ZhuohengLee/Squid-Robot/ESP32/KalmanFilter.h

/**********************************************************************
 * KalmanFilter.h
 *
 * Three-state depth filter tracking position, velocity, and acceleration.
 *********************************************************************/

#ifndef ESP32_KALMAN_FILTER_H
#define ESP32_KALMAN_FILTER_H

#include <Arduino.h>

class KalmanFilter {
public:
    KalmanFilter();

    void reset(float position = 0.0f, float velocity = 0.0f, float acceleration = 0.0f);
    void update(float measurement, float dt);

    float getPosition() const;
    float getVelocity() const;
    float getAcceleration() const;

private:
    float _x[3];
    float _p[3][3];
    float _q[3];
    float _r;
};

#endif // ESP32_KALMAN_FILTER_H
