ZhuohengLee/Squid-Robot/ESP32/AutoNavigator.h

/**********************************************************************
 * AutoNavigator.h
 *
 * 这个文件声明基于超声波数据的自动寻路模块。
 *********************************************************************/

#ifndef ESP32_AUTO_NAVIGATOR_H
#define ESP32_AUTO_NAVIGATOR_H

#include <Arduino.h>
#include "ForwardControl.h"
#include "LeftTurnControl.h"
#include "RightTurnControl.h"
#include "UltrasonicManager.h"

class AutoNavigator {
public:
    AutoNavigator();

    // 注入前进和转向子系统控制器。
    void begin(ForwardControl* forwardControl, LeftTurnControl* leftTurnControl, RightTurnControl* rightTurnControl);

    // 打开或关闭自动寻路。
    void setEnabled(bool enabled);
    bool isEnabled() const;

    // 根据滤波后的超声波数据更新自动寻路决策。
    void update(const UltrasonicManager& ultrasonicManager, uint32_t nowMs);

private:
    ForwardControl* _forwardControl;
    LeftTurnControl* _leftTurnControl;
    RightTurnControl* _rightTurnControl;
    bool _enabled;
    uint32_t _decisionLockUntilMs;
};

#endif // ESP32_AUTO_NAVIGATOR_H
