ZhuohengLee/Squid-Robot/(commit log)

2026-03-24 Move motion timing to ESP32 and simplify Minima executor
2026-03-24 Fix firmware comments and add OTA support
    [AutoNavigator.cpp, AutoNavigator.h, CH9434A.cpp, CH9434A.h, CommandHandler.cpp, CommandHandler.h, DepthController.cpp, DepthController.h]
2026-03-25 Refresh README for current firmware
2026-03-25 Simplify sensor output and fix depth wiring docs
    [DepthSensorManager.cpp, DepthSensorManager.h, ESP32.ino, Protocol.h, SensorHub.cpp]
2026-03-26 Update depth handling and sensor status output
2026-03-26 Upgrade buoyancy control with predictive PWM
